moliverxxii/sequencer-project/sequencer-picture.jpg

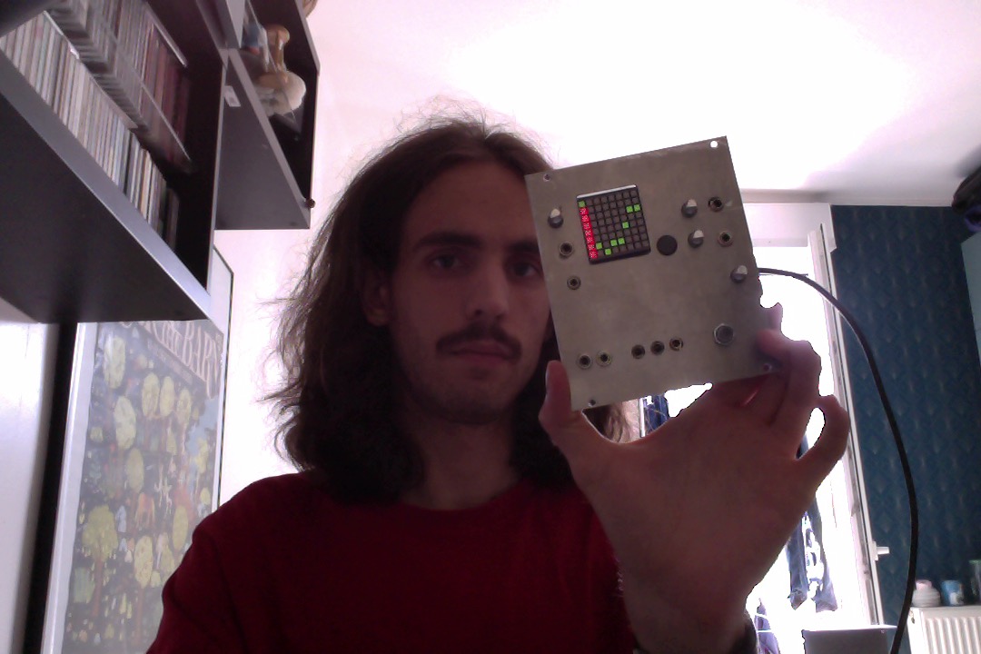
sequencer-picture.jpg
