moliverxxii/sequencer-project/README.md

! : 1 LE SCHEMA N'EST PAS ENCORE A DISPOSITION, MERCI DE VOTRE COMPREHENSION. 
! : 2 LA CONFIGURATION ELECTRONIQUE DE LA CARTE NUCLEO EST A PRENDRE EN COMPTE. (VOIR LE RAPPORT)

ce projet est base autour de la carte STM32 NUCLEO32 L432KC. parmi les fonctionnalites se trouvent : 
- generation de sequences de 8 pas aleatoires avec un generateur de bruit analogique,
- sauvegarde des sequences,
- calibrage "Hard Coding" du signal de commande de frequence (1 V/Octave),
- jeu musical sur plusieurs gammes differentes.
