moliverxxii/sequencer-project/Core/Src/main.c

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
/* Includes ------------------------------------------------------------------*/
#include "main.h"

ADC_HandleTypeDef hadc1;
DMA_HandleTypeDef hdma_adc1;

DAC_HandleTypeDef hdac1;

I2C_HandleTypeDef hi2c1;

RNG_HandleTypeDef hrng;

TIM_HandleTypeDef htim2;
TIM_HandleTypeDef htim6;

UART_HandleTypeDef huart2;

/* USER CODE BEGIN PV */
seq_TypeDef seq_struct;
uint16_t seq_adc[3];
uint16_t conversion_table[0x1000];
seq_parametres_TypeDef parametres;
seq_memoire_TypeDef memory;

/* USER CODE END PV */

void SystemClock_Config(void);
static void MX_GPIO_Init(void);
static void MX_DMA_Init(void);
static void MX_USART2_UART_Init(void);
static void MX_ADC1_Init(void);
static void MX_DAC1_Init(void);
static void MX_I2C1_Init(void);
static void MX_TIM2_Init(void);
static void MX_RNG_Init(void);
static void MX_TIM6_Init(void);
/**
  * @brief  The application entry point.
  * @retval int
  */
int main(void)
{
  /* MCU Configuration--------------------------------------------------------*/

  /* Reset of all peripherals, Initializes the Flash interface and the Systick. */
  HAL_Init();

  /* Configure the system clock */
  SystemClock_Config();

  /* Initialize all configured peripherals */
  MX_GPIO_Init();
  MX_DMA_Init();
  MX_USART2_UART_Init();
  MX_ADC1_Init();
  MX_DAC1_Init();
  MX_I2C1_Init();
  MX_TIM2_Init();
  MX_RNG_Init();
  MX_TIM6_Init();
  /* USER CODE BEGIN 2 */


  for(int i=0; i<8; ++i)
  {
	  memory.def[i] = 0;
  }
  memory.position = 0;


  const int32_t n1_cal = 1927;
  const int32_t n2_cal = 2167;
  const float v1_pre_correction = 1.0078; //V pré-correction
  const float v2_pre_correction = 2.2395; //V pré-correction
  const float gain_ideal = 1./12.;
  const float offset_ideal = -gain_ideal * 60;

//const float offset_correction = 0;
//const float gain_correction = 1;

  const float gain_correction = gain_ideal
		  * (n1_cal - n2_cal)
		  /(v1_pre_correction - v2_pre_correction);
  const float offset_correction =
		  (
				  (n1_cal - n2_cal) * offset_ideal
				  + n2_cal * v1_pre_correction
				  - n1_cal * v2_pre_correction)
		  /(v1_pre_correction - v2_pre_correction);

  int32_t temp;
  uint32_t i;

  for(i=0; i<0x1000; ++i)
  {
  	  temp = gain_correction * i + offset_correction;
  	  if(temp>0xFFF) temp = 0xFFF;
  	  else if(temp<0) temp = 0;
  	  conversion_table[i] = (uint16_t) (temp);
  }


  uint8_t mat_init[3] = {0x21,0xE0,0x81};
  HAL_Delay(1);
  RNG->CR |=1;
  for(int i=0; i<3;++i)
  {
	  HAL_I2C_Master_Transmit(&hi2c1, 0xE0, &(mat_init[i]), 1, 1000);
	  HAL_Delay(1);
  }
  //HAL_I2C_Master_Transmit(&hi2c1, 0xE0, table, 17, 1000);
  seq_struct.step = 0;
  seq_struct.leds[0] = 0;

//  seq_gen(&seq_struct);
  HAL_ADC_Start_DMA(&hadc1, (uint32_t*) seq_adc, 3);
  HAL_DAC_Start(&hdac1, DAC_CHANNEL_1);
  parametres.tonique_jck = 60;
  parametres.tonique_jck = 60;
  seq_read_mem(&memory);

  HAL_TIM_Base_Start_IT(&htim6);

  HAL_TIM_Base_Start_IT(&htim2);
  /* USER CODE END 2 */

  /* Infinite loop */
  /* USER CODE BEGIN WHILE */

  while (1)
  {


    /* USER CODE END WHILE */

    /* USER CODE BEGIN 3 */
  }
  /* USER CODE END 3 */
}

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
