moliverxxii/sequencer-project/Core/Inc/main.h

#define WHEEL_A_Pin GPIO_PIN_14
#define WHEEL_A_GPIO_Port GPIOC
#define WHEEL_A_EXTI_IRQn EXTI15_10_IRQn
#define CLOCK_Pin GPIO_PIN_15
#define CLOCK_GPIO_Port GPIOC
#define CLOCK_EXTI_IRQn EXTI15_10_IRQn
#define MCO_Pin GPIO_PIN_0
#define MCO_GPIO_Port GPIOA
#define CV_MODE_Pin GPIO_PIN_1
#define CV_MODE_GPIO_Port GPIOA
#define VCP_TX_Pin GPIO_PIN_2
#define VCP_TX_GPIO_Port GPIOA
#define CV_TONIC_2_Pin GPIO_PIN_3
#define CV_TONIC_2_GPIO_Port GPIOA
#define CV_OUT_Pin GPIO_PIN_4
#define CV_OUT_GPIO_Port GPIOA
#define NO_Pin GPIO_PIN_5
#define NO_GPIO_Port GPIOA
#define NOA6_Pin GPIO_PIN_6
#define NOA6_GPIO_Port GPIOA
#define CV_TONIC_1_Pin GPIO_PIN_7
#define CV_TONIC_1_GPIO_Port GPIOA
#define NOB0_Pin GPIO_PIN_0
#define NOB0_GPIO_Port GPIOB
#define WHEEL_B_Pin GPIO_PIN_1
#define WHEEL_B_GPIO_Port GPIOB
#define WHEEL_B_EXTI_IRQn EXTI1_IRQn
#define LAST_STEP_Pin GPIO_PIN_8
#define LAST_STEP_GPIO_Port GPIOA
#define TRIG_OUT_Pin GPIO_PIN_11
#define TRIG_OUT_GPIO_Port GPIOA
#define WHEEL_BTN_Pin GPIO_PIN_12
#define WHEEL_BTN_GPIO_Port GPIOA
#define WHEEL_BTN_EXTI_IRQn EXTI15_10_IRQn
#define SWDIO_Pin GPIO_PIN_13
#define SWDIO_GPIO_Port GPIOA
#define SWCLK_Pin GPIO_PIN_14
#define SWCLK_GPIO_Port GPIOA
#define VCP_RX_Pin GPIO_PIN_15
#define VCP_RX_GPIO_Port GPIOA
#define NO_BTN_LD3_Pin GPIO_PIN_3
#define NO_BTN_LD3_GPIO_Port GPIOB
#define PREV_SEQ_Pin GPIO_PIN_4
#define PREV_SEQ_GPIO_Port GPIOB
#define NEXT_SEQ_Pin GPIO_PIN_5
#define NEXT_SEQ_GPIO_Port GPIOB
#define NEXT_SEQ_EXTI_IRQn EXTI9_5_IRQn
#define LED_MAT_CL_Pin GPIO_PIN_6
#define LED_MAT_CL_GPIO_Port GPIOB
#define LED_MAT_DA_Pin GPIO_PIN_7
#define LED_MAT_DA_GPIO_Port GPIOB
