moliverxxii/sequencer-project/(commit log)

2021-03-02 Corrected brackets
2021-03-09 j'ai fait une potite fonction pour afficher un tableau de note, ça s'appelle tabnot
